E-yantra-AOT/Sentinel-Swarm/simulation/SIMULATION_ROADMAP.md

# Gazebo Simulation: Advanced Roadmap & Future Capabilities

This document outlines the high-impact physics and simulation features that can be added to the Sentinel Swarm Gazebo environment to push the project into "God-Tier" territory for hackathon judging.

---

## 🔥 1. Thermal Camera Simulation
**Concept:** Augment the standard RGB camera with a simulated thermal imaging sensor.
*   **Implementation:** Add the `gz::sim::systems::ThermalSensor` plugin to `aerial_v1.urdf`. Assign a specific heat signature (e.g., 37°C) to the casualty mannequin in `disaster_zone.sdf`.
*   **Hackathon Impact:** High. Disaster response is heavily reliant on thermal imaging. Showing a synchronized split-screen in RViz2 (Standard RGB + Thermal Heatmap) instantly elevates the perceived professionalism of the vision stack.

## 🌪️ 2. Wind & Turbulence Injection
**Concept:** Introduce environmental chaos to test flight controller stability.
*   **Implementation:** Add the `gz::sim::systems::WindEffects` plugin to the Gazebo world. Configure randomized wind gusts and localized updrafts around the collapsed concrete slabs.
*   **Hackathon Impact:** High. Proves the custom cascaded PID controller and 9-state EKF (Extended Kalman Filter) are mathematically robust. Watching the swarm actively fight turbulence to maintain Voronoi formation is a massive flex.

## 🤖 3. Heterogeneous Swarm Simulation (Air + Ground)
**Concept:** Bring the Sentinel Ground Node into the simulation alongside the Aerial Nodes.
*   **Implementation:** 
    1. Write a new `ground_v1.urdf` using Gazebo's `DiffDrive` plugin.
    2. Spawn ground bots into the disaster world.
    3. Bridge the simulated ground bots into the same Python Swarm Behavior Tree, mimicking the physical XBee mesh network.
*   **Hackathon Impact:** Extreme. A heterogeneous swarm (coordinating air and ground assets simultaneously) is the holy grail of modern rescue robotics, closely mimicking DARPA SubT challenge scenarios.

## 🏢 4. Verticality & Confined Indoor Flight
**Concept:** Move beyond flat-ground outdoor navigation.
*   **Implementation:** Modify `disaster_zone.sdf` to include a multi-story collapsed structure (e.g., a parking garage or a building with blown-out windows). 
*   **Hackathon Impact:** Extreme. Forces the `RRT*` potential field planner and the 3D Voxel Ray-Casting map to navigate *vertically* through confined spaces. This proves the SLAM implementation is truly 3D, rather than a 2D grid disguised as 3D.

## 🔋 5. True Battery Degradation Physics
**Concept:** Tie physical drone limitations to the AI behavior tree.
*   **Implementation:** Map the simulated motor RPM to a virtual voltage drop inside `sim_flight_bridge.py`. As voltage degrades, physically cap the max thrust of the Gazebo `MulticopterVelocityControl`.
*   **Hackathon Impact:** Moderate to High. Proves the `RTB` (Return to Base) logic in the Swarm Behavior Tree is dynamically driven by real-world physics constraints rather than a simple hardcoded timer.

---

## 🌌 6. NVIDIA Isaac Sim Integration (Advanced Replicator Workflow)
**Concept:** Upgrading from Gazebo Harmonic to NVIDIA Isaac Sim to leverage RTX hardware for photorealistic disaster rendering and synthetic AI training data.
*   **Feasibility Research & Hardware Constraints (RTX 4050 6GB VRAM):** 
    *   *Constraint:* Isaac Sim officially recommends 16GB of VRAM. Running full Omniverse GUI on a 6GB RTX 4050 will cause memory bottlenecks. 
    *   *Solution:* We will run Isaac Sim in **Headless Native Python Mode** (skipping the heavy UI) or use the `OmniGibson` lightweight wrapper. We can also stream the simulation via WebRTC to lower VRAM overhead.
*   **Implementation Plan:**
    1.  **ROS 2 Bridge:** Utilize the **Isaac ROS Bridge** to seamlessly connect our existing `sim_flight_bridge.py` (Twist commands and Swarm logic) to the Isaac Sim environment. We can utilize the open-source **Pegasus Simulator** extension designed specifically for multi-rotor UAVs in Isaac.
    2.  **Omniverse Replicator (Synthetic Data):** We will build a pipeline using `omni.replicator.core` to automatically generate thousands of annotated training images of our disaster casualty mannequin. 
    3.  **Thermal Material Definition Language (MDL):** Instead of standard RGB, we will apply custom thermal emission MDLs to the mannequin. Replicator will output perfectly bounded thermal datasets.
*   **Hackathon Impact:** Absolute Game-Changer. We can tell judges, *"Because physical thermal data of trapped casualties is impossible to collect, we built an Isaac Sim Omniverse Replicator pipeline to generate synthetic thermal datasets, which we then used to fine-tune our RT-DETR/YOLO model."* This bridges the gap between Simulation and AI Training, showcasing enterprise-level ML Ops.
