E-yantra-AOT/Sentinel-Swarm/assets/IMG20260917142642.jpg

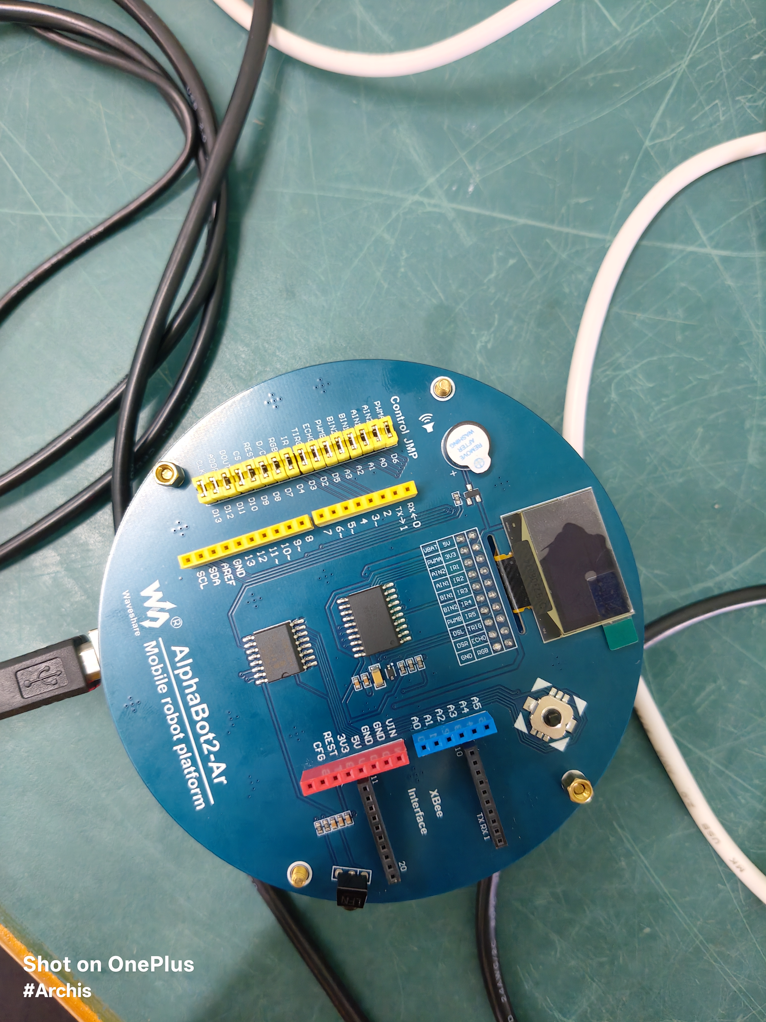
assets/IMG20260917142642.jpg
