E-yantra-AOT/Sentinel-Swarm/(commit log)

2026-09-27 Initial commit: Sentinel Swarm Architecture
    [model.ncnn.param]
2026-09-27 feat: Phase 7 complete — Weighted Borda Count swarm negotiation with leader election and scan sweep
2026-09-27 feat: Add aerial_v1 URDF, Gazebo disaster world, and ROS2 multi-drone spawn launcher
    [aerial_v1.urdf, disaster_zone.sdf]
2026-09-27 Gazebo Simulation Done
    [aerial_v1.urdf]
2026-09-28 Gazeboo Update
    [aerial_v1.urdf]
2026-10-02 feat: Add Pi5 drone companion computer, FC wiring guide, and full swarm launcher
2026-10-02 chore: Sync local changes - motor tuning, drone companion, cleanup
2026-10-02 fix: switch flight controller connection from UART to USB Type-C
    [drone_companion.py]
2026-10-02 chore: Clean up repository to only keep essential core files
    [model.ncnn.param]
2026-10-03 Update aerial node: Add XBee swarm intelligence logic and atexit safety failsafe to ensure motors disarm on kill
    [drone_vision_nav.py]
2026-10-08 Add full heterogeneous swarm and aerial assembly photo gallery to README
